jonasled2/LED-Tisch/Bilder/IMG_0707.JPG

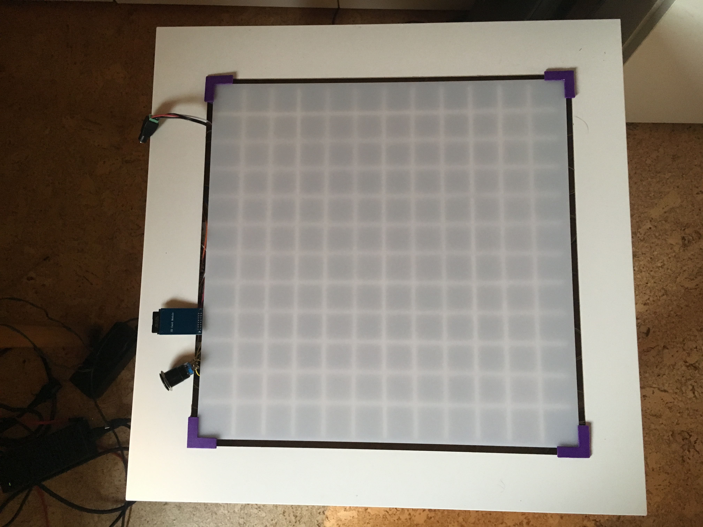
Bilder/IMG_0707.JPG
