jonasled2/LED-Tisch/README.md

# Moved to kurz.ml/qxEc8y

# LED-Tisch

Bauannleitung unter https://jonasled.tk/projekte/led-tisch.html
