jonasled2/LED-Tisch/Bilder/IMG_0706.JPG

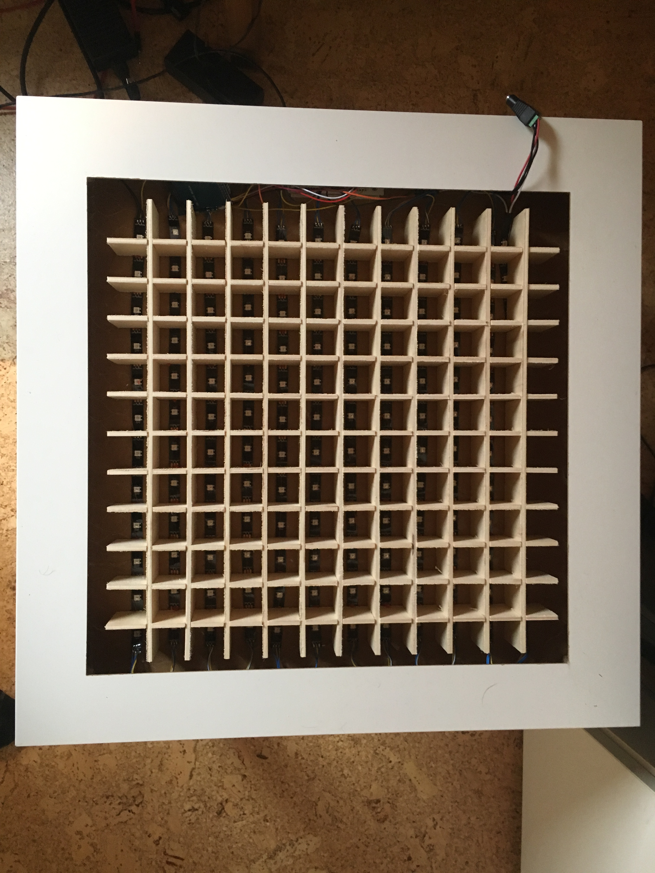
Bilder/IMG_0706.JPG
