jonasled2/LED-Tisch/Bilder/IMG_0708.JPG

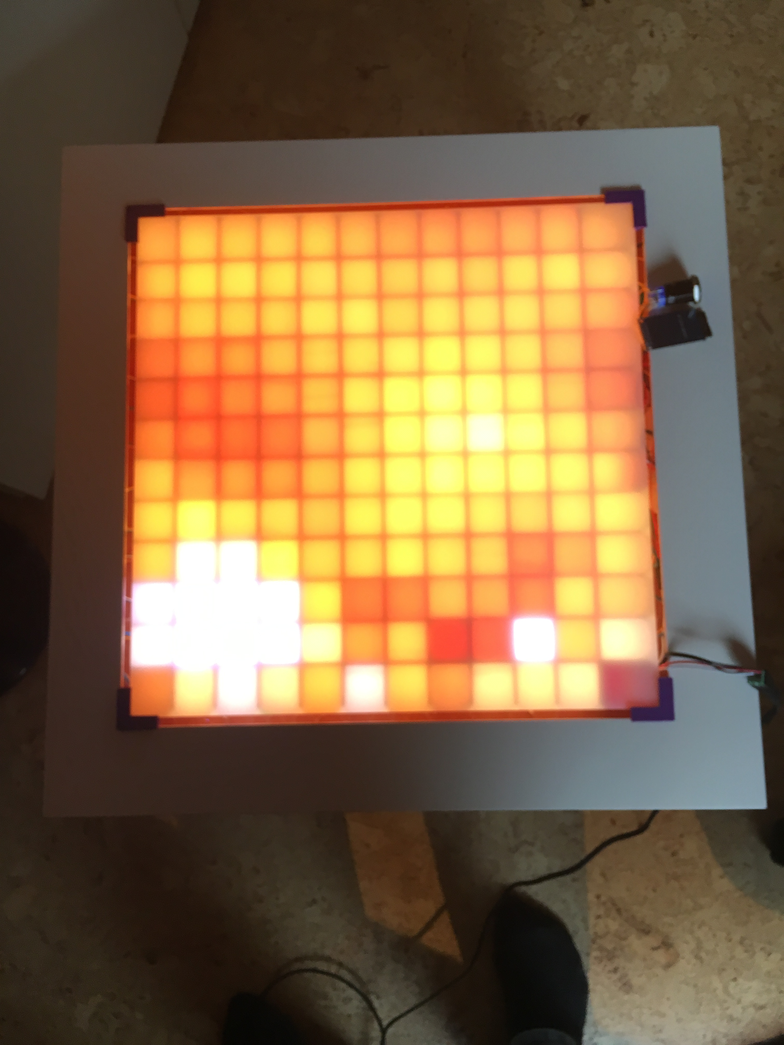
Bilder/IMG_0708.JPG
