jonasled2/LED-Tisch/Bilder/layout.jpg

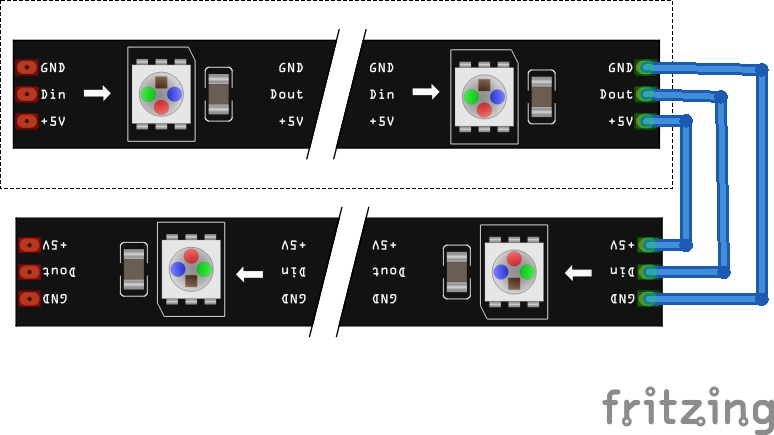
Bilder/layout.jpg
