jonasled2/LED-Tisch/Bilder/Schaltplan_Steckplatine.png

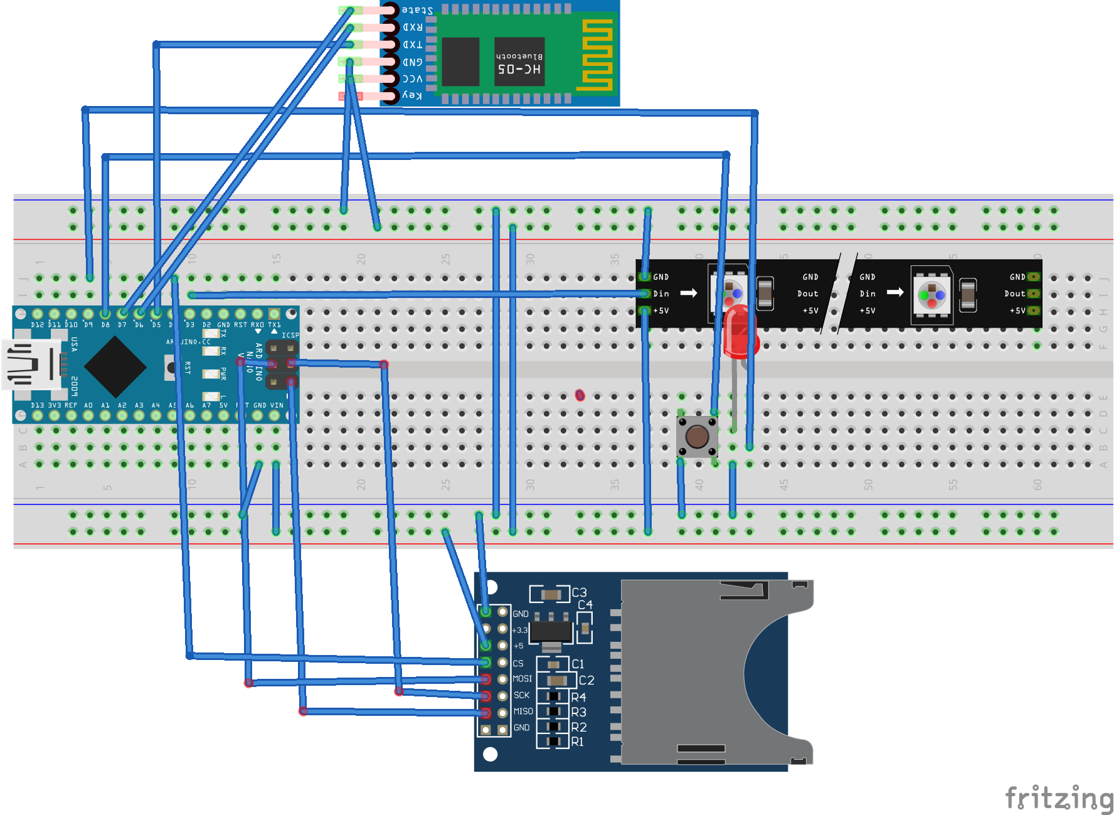
Bilder/Schaltplan_Steckplatine.png
