jonasled2/LED-Tisch/Matrix.dxf

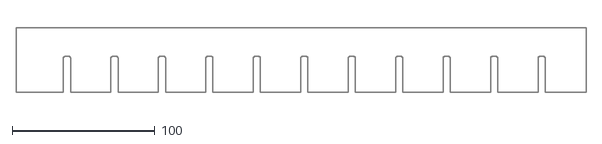
[picture p7: CAD file, 2018-01-04]
Matrix.dxf
400.0 x 45.0
