jonasled2/LED-Tisch/(list of files, drawings)

Other design files:
Schaltplan.fzz
