jonasled2/LED-Tisch/Bilder/IMG_0705.JPG

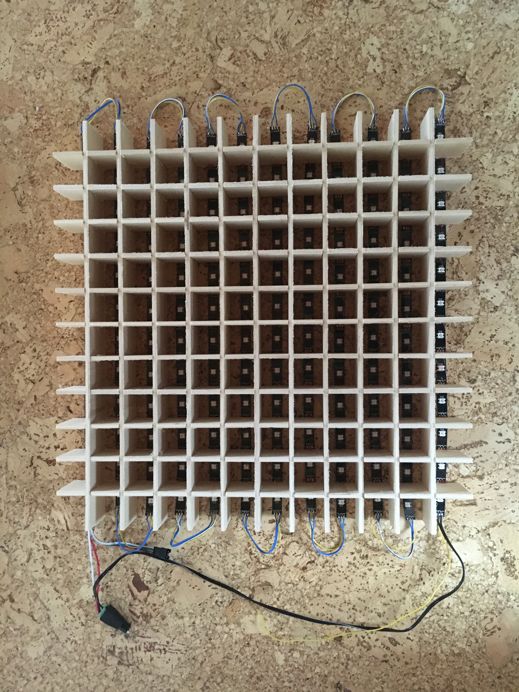
Bilder/IMG_0705.JPG
